ianfm/foc-driver-pcb/README.md

# foc-driver-pcb
BLDC driver aimed at FOC motor control
