ianfm/foc-driver-pcb/drv8323-breakout/drv8323-breakout.kicad_pcb

## KiCad design drv8323-breakout/drv8323-breakout.kicad_pcb (2026-03-18)

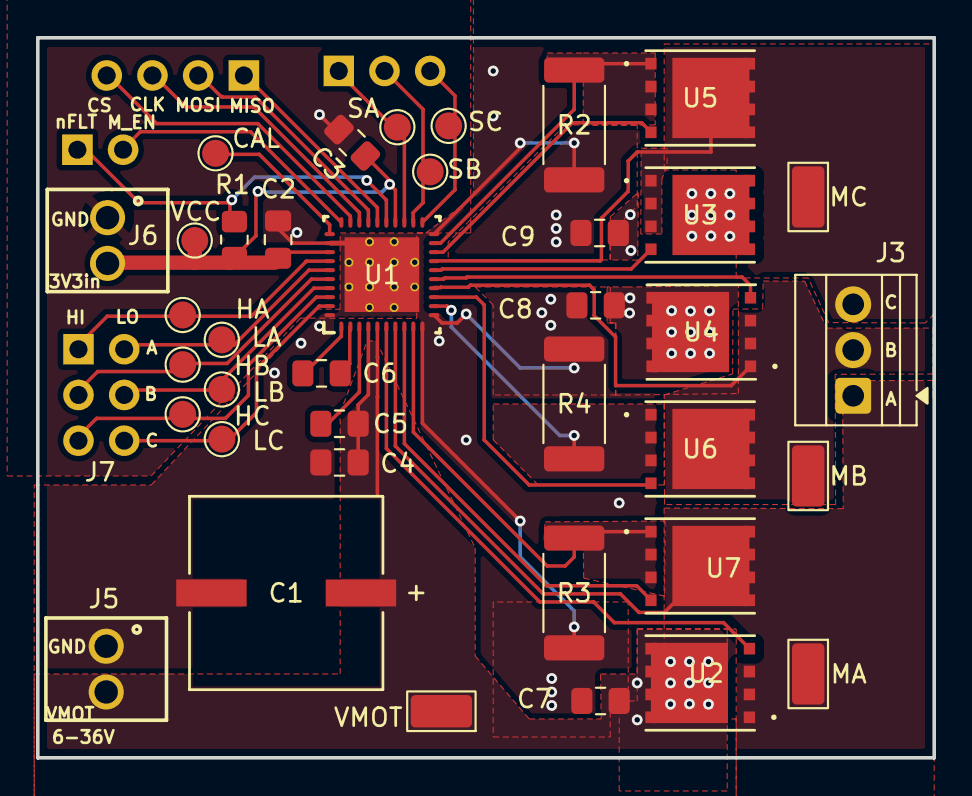
[picture p1: board drv8323-breakout.kicad_pcb from above]

Board: 2 copper layers, 49.8 x 40.0 mm, 43 parts (0 on the bottom side), 35 nets.

Parts:
C1: 47uF; PCAP_10x10-ELECT_NCA
C2, C5: 1 uF; C_0805_2012Metric_Pad1.18x1.45mm_HandSolder
C3, C4: 0.1 uF; C_0805_2012Metric_Pad1.18x1.45mm_HandSolder
C6: 47 nF; C_0805_2012Metric_Pad1.18x1.45mm_HandSolder
C7, C8, C9: C; C_0805_2012Metric_Pad1.18x1.45mm_HandSolder
CAL: TestPoint; TestPoint_Pad_D1.5mm
HA: TestPoint; TestPoint_Pad_D1.5mm
HB: TestPoint; TestPoint_Pad_D1.5mm
HC: TestPoint; TestPoint_Pad_D1.5mm
J1: Conn_01x02_Pin; PinHeader_1x02_P2.54mm_Vertical
J2: Conn_01x04_Pin; PinHeader_1x04_P2.54mm_Vertical
J3: Screw_Terminal_01x03; TerminalBlock_Xinya_XY308-2.54-3P_1x03_P2.54mm_Horizontal
J4: Conn_01x03_Pin; PinHeader_1x03_P2.54mm_Vertical
J5, J6: Screw_Terminal_01x02; ScrewTerminal
J7: Conn_02x03_Odd_Even; PinHeader_2x03_P2.54mm_Vertical
LA: TestPoint; TestPoint_Pad_D1.5mm
LB: TestPoint; TestPoint_Pad_D1.5mm
LC: TestPoint; TestPoint_Pad_D1.5mm
MA: TestPoint; TestPoint_Keystone_5015_Micro_Mini
MB: TestPoint; TestPoint_Keystone_5015_Micro_Mini
MC: TestPoint; TestPoint_Keystone_5015_Micro_Mini
NT2: NetTie_2; NetTie-2_SMD_Pad0.28mm
R1: R_US; R_0805_2012Metric_Pad1.20x1.40mm_HandSolder
R2, R3, R4: CSS2H-2512K-2L00F; R_2512_6332Metric_Pad1.40x3.35mm_HandSolder
SA: TestPoint; TestPoint_Pad_D1.5mm
SB: TestPoint; TestPoint_Pad_D1.5mm
SC: TestPoint; TestPoint_Pad_D1.5mm
U1: DRV8323HRTAR; RTA0040B
U2, U3, U4, U5, U6, U7: CSD18534Q5A; DQJ8
VCC: TestPoint; TestPoint_Pad_D1.5mm
VMOT: TestPoint; TestPoint_Keystone_5015_Micro_Mini

Connections:
/Motor Control/SPA: R3.1, U1.9 (SPA), U7.1 (S), U7.2 (S), U7.3 (S)
/Motor Control/SPB: R4.1, U1.12 (SPB), U6.1 (S), U6.2 (S), U6.3 (S)
/Motor Control/SPC: R2.1, U1.19 (SPC), U5.1 (S), U5.2 (S), U5.3 (S)
AGND: C2.1, C3.1, J6.1, NT2.2, U1.32 (AGND)
CAL: CAL.1, U1.31 (CAL)
MOT_A: J3.1, MA.1, U1.7 (SHA), U2.1 (S), U2.2 (S), U2.3 (S), U7.5 (D), U7.6 (D), U7.7 (D), U7.8 (D), U7.9 (ep)
MOT_B: J3.2, MB.1, U1.14 (SHB), U4.1 (S), U4.2 (S), U4.3 (S), U6.5 (D), U6.6 (D), U6.7 (D), U6.8 (D), U6.9 (ep)
MOT_C: J3.3, MC.1, U1.17 (SHC), U3.1 (S), U3.2 (S), U3.3 (S), U5.5 (D), U5.6 (D), U5.7 (D), U5.8 (D), U5.9 (ep)
MOT_EN: J1.2, U1.30 (ENABLE)
NFLT: J1.1, R1.2, U1.25 (FAULT_N)
unnamed: C6.1, U1.2 (CPH)
unnamed: C6.2, U1.1 (CPL)
unnamed: U1.6 (GHA), U2.4 (G)
unnamed: U1.15 (GHB), U4.4 (G)
unnamed: U1.16 (GHC), U3.4 (G)
unnamed: U1.8 (GLA), U7.4 (G)
unnamed: U1.13 (GLB), U6.4 (G)
unnamed: U1.18 (GLC), U5.4 (G)
unnamed: C5.2, U1.3 (VCP)
PGND: C1.2, C4.2, C7.1, C8.2, C9.2, J5.1, NT2.1, R2.2, R3.2, R4.2, U1.10 (SNA), U1.11 (SNB), U1.20 (SNC), U1.40 (PGND), U1.41 (PAD)
PWM_HA: HA.1, J7.1, U1.34 (INHA)
PWM_HB: HB.1, J7.3, U1.36 (INHB)
PWM_HC: HC.1, J7.5, U1.38 (INHC)
PWM_LA: J7.2, LA.1, U1.35 (INLA)
PWM_LB: J7.4, LB.1, U1.37 (INLB)
PWM_LC: J7.6, LC.1, U1.39 (INLC)
SNSA: J4.1, SA.1, U1.23 (SOA)
SNSB: J4.2, SB.1, U1.22 (SOB)
SNSC: J4.3, SC.1, U1.21 (SOC)
SPI_CLK: J2.3, U1.28 (VDS_SCLK)
SPI_CS: J2.4, U1.29 (GAIN_SCS_N)
SPI_MISO: J2.1, U1.26 (MODE_SDO)
SPI_MOSI: J2.2, U1.27 (IDRIVE_SDI)
VCC: C2.2, C3.2, J6.2, R1.1, U1.24 (VREF), U1.33 (DVDD), VCC.1
V_MOT: C1.1, C4.1, C5.1, C7.2, C8.1, C9.1, J5.2, U1.4 (VM), U1.5 (VDRAIN), U2.5 (D), U2.6 (D), U2.7 (D), U2.8 (D), U2.9 (ep), U3.5 (D), U3.6 (D), U3.7 (D), U3.8 (D), U3.9 (ep), U4.5 (D), U4.6 (D), U4.7 (D), U4.8 (D), U4.9 (ep), VMOT.1
