ianfm/foc-driver-pcb/mosfet-breakout/mosfet-breakout/mosfet-breakout.kicad_pcb

## KiCad design mosfet-breakout/mosfet-breakout/mosfet-breakout.kicad_pcb (2026-03-17)

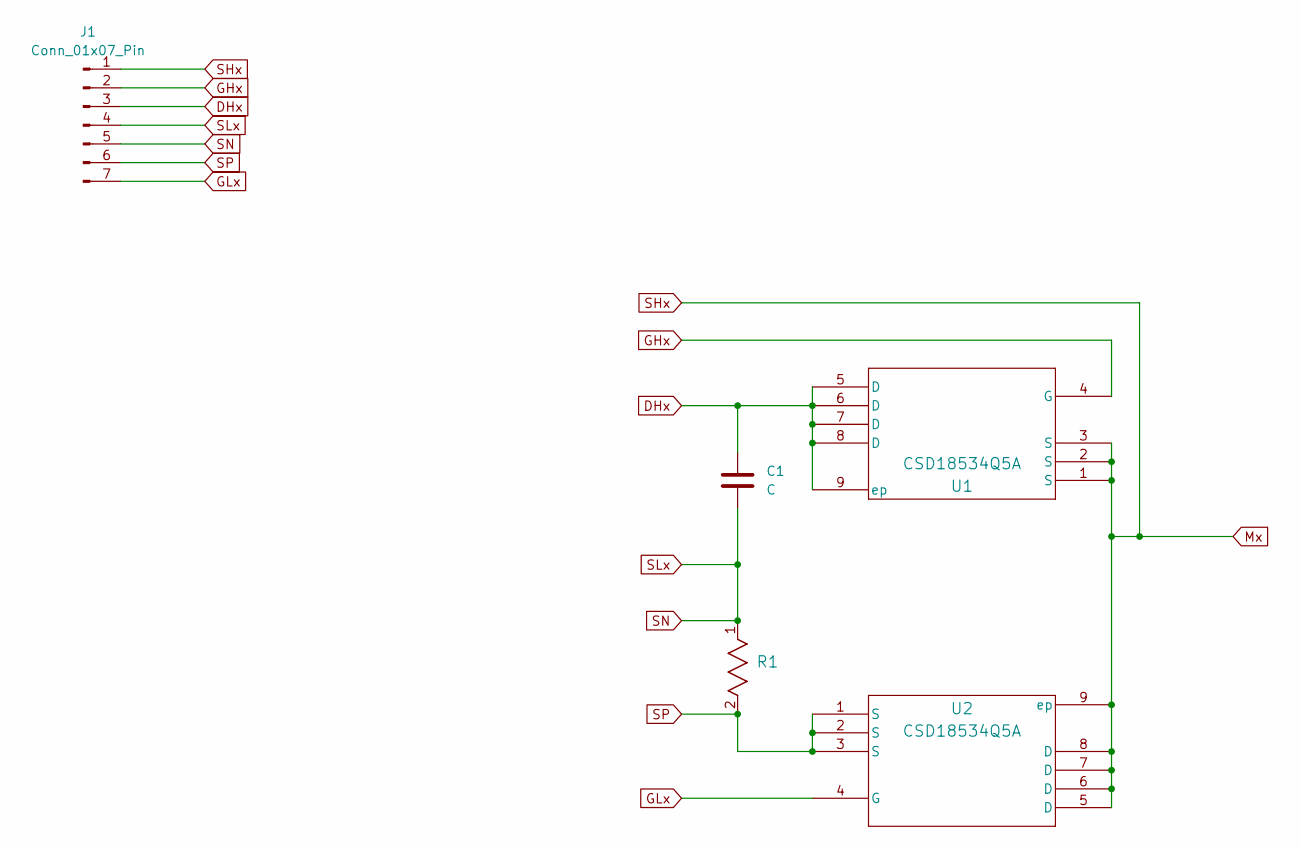
[picture p2: schematic mosfet-breakout.kicad_sch]

Parts:
C1: C; C_0805_2012Metric_Pad1.18x1.45mm_HandSolder
J1: Conn_01x07_Pin; PinHeader_1x07_P2.54mm_Vertical
R1: CSS2H-2512K-2L00F; R_2512_6332Metric_Pad1.40x3.35mm_HandSolder
U1, U2: CSD18534Q5A; DQJ8

Connections:
DHx: C1.1, J1.3, U1.5 (D), U1.6 (D), U1.7 (D), U1.8 (D), U1.9 (ep)
GHx: J1.2, U1.4 (G)
GLx: J1.7, U2.4 (G)
Mx: J1.1, U1.1 (S), U1.2 (S), U1.3 (S), U2.5 (D), U2.6 (D), U2.7 (D), U2.8 (D), U2.9 (ep)
SLx: C1.2, J1.4, J1.5, R1.1
SP: J1.6, R1.2, U2.1 (S), U2.2 (S), U2.3 (S)

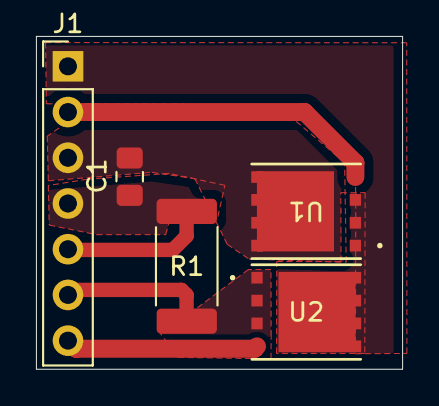
[picture p3: board mosfet-breakout.kicad_pcb from above]

Board: 2 copper layers, 20.3 x 18.5 mm, 5 parts (0 on the bottom side), 6 nets.
