ianfm/foc-driver-pcb/esp32-drv8323-driver/haptic-wheel-pcb.kicad_pcb

## KiCad design esp32-drv8323-driver/haptic-wheel-pcb.kicad_pcb (2026-03-16)

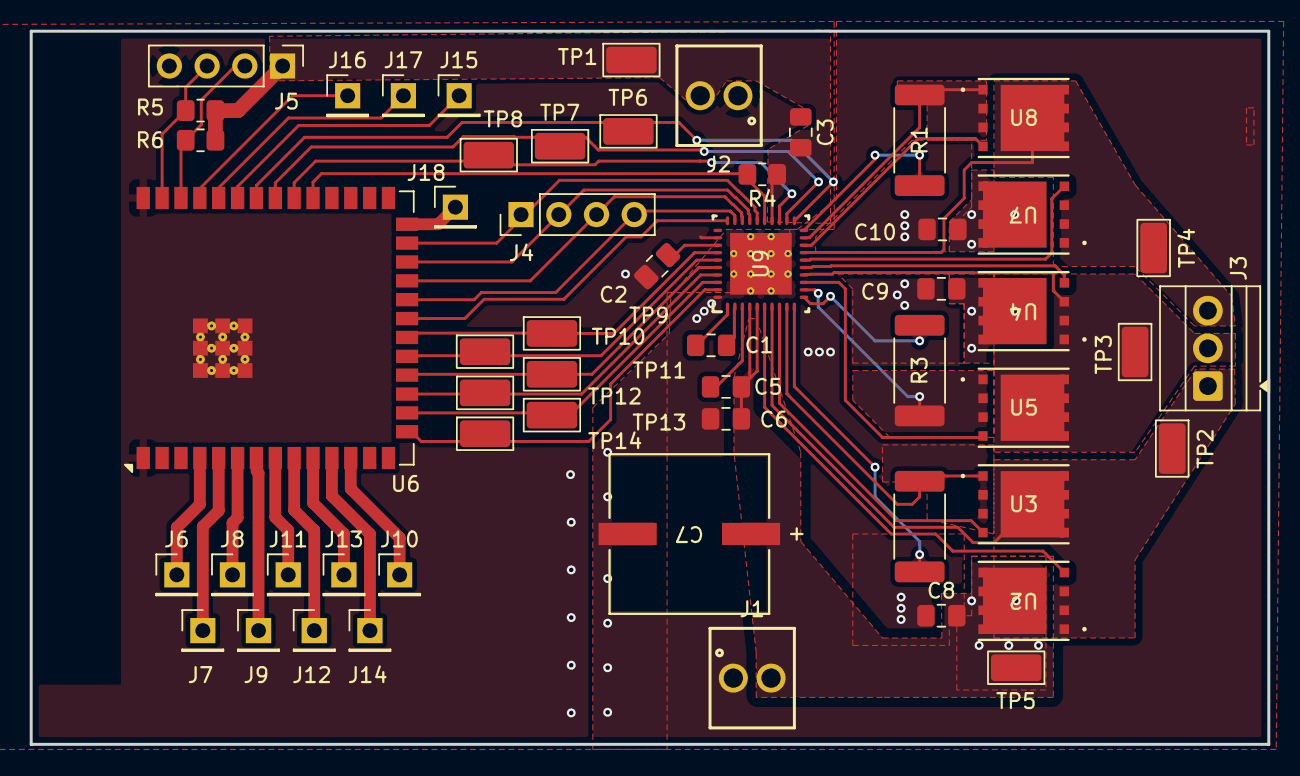
[picture p4: board haptic-wheel-pcb.kicad_pcb from above]

Board: 2 copper layers, 83.3 x 48.0 mm, 55 parts (0 on the bottom side), 53 nets.

Parts:
C1: 47 nF; C_0805_2012Metric_Pad1.18x1.45mm_HandSolder
C2, C5: 1 uF; C_0805_2012Metric_Pad1.18x1.45mm_HandSolder
C3, C6: 0.1 uF; C_0805_2012Metric_Pad1.18x1.45mm_HandSolder
C7: 47uF; PCAP_10x10-ELECT_NCA
C8, C9, C10: C; C_0805_2012Metric_Pad1.18x1.45mm_HandSolder
J1, J2: Screw_Terminal_01x02; ScrewTerminal
J3: Screw_Terminal_01x03; TerminalBlock_Xinya_XY308-2.54-3P_1x03_P2.54mm_Horizontal
J4, J5: Conn_01x04_Pin; PinHeader_1x04_P2.54mm_Vertical
J6, J7, J8, J9, J10, J11, J12, J13, J14, J15, J16, J17, J18: Conn_01x01_Pin; PinHeader_1x01_P2.54mm_Vertical
R1, R2, R3: CSS2H-2512K-2L00F; R_2512_6332Metric_Pad1.40x3.35mm_HandSolder
R4, R5, R6: R_US; R_0805_2012Metric_Pad1.20x1.40mm_HandSolder
TP1, TP2, TP3, TP4, TP5, TP6, TP7, TP8, TP9, TP10, TP11, TP12, TP13, TP14: TestPoint; TestPoint_Keystone_5015_Micro_Mini
U2, U3, U4, U5, U7, U8: CSD18534Q5A; DQJ8
U6: ESP32-S3-WROOM-2
U9: DRV8323HRTAR; RTA0040B

Connections:
/Motor Control/SNA: R2.2, U9.10 (SNA)
/Motor Control/SNB: R3.2, U9.11 (SNB)
/Motor Control/SNC: R1.2, U9.20 (SNC)
/Motor Control/SPA: R2.1, U3.1 (S), U3.2 (S), U3.3 (S), U9.9 (SPA)
/Motor Control/SPB: R3.1, U5.1 (S), U5.2 (S), U5.3 (S), U9.12 (SPB)
/Motor Control/SPC: R1.1, U8.1 (S), U8.2 (S), U8.3 (S), U9.19 (SPC)
AGND: C2.1, C3.1, J2.1, J5.4, U6.1 (GND), U6.40 (GND), U6.41 (GND), U9.32 (AGND)
MOT_A: J3.1, TP2.1, U2.1 (S), U2.2 (S), U2.3 (S), U3.5 (D), U3.6 (D), U3.7 (D), U3.8 (D), U3.9 (ep), U9.7 (SHA)
MOT_B: J3.2, TP3.1, U4.1 (S), U4.2 (S), U4.3 (S), U5.5 (D), U5.6 (D), U5.7 (D), U5.8 (D), U5.9 (ep), U9.14 (SHB)
MOT_C: J3.3, TP4.1, U7.1 (S), U7.2 (S), U7.3 (S), U8.5 (D), U8.6 (D), U8.7 (D), U8.8 (D), U8.9 (ep), U9.17 (SHC)
MOT_EN: U6.21 (IO13), U9.30 (ENABLE)
NFLT: R4.2, U6.31 (IO38), U9.25 (FAULT_N)
unnamed: J6.1, U6.4 (IO4)
unnamed: J7.1, U6.5 (IO5)
unnamed: J8.1, U6.6 (IO6)
unnamed: J9.1, U6.7 (IO7)
unnamed: J10.1, U6.12 (IO8)
unnamed: J11.1, U6.8 (IO15)
unnamed: J12.1, U6.9 (IO16)
unnamed: J13.1, U6.10 (IO17)
unnamed: J14.1, U6.11 (IO18)
unnamed: J15.1, U6.35 (MTMS/IO42)
unnamed: J16.1, U6.37 (TXD0/IO43)
unnamed: J17.1, U6.36 (RXD0/IO44)
unnamed: J18.1, U6.26 (IO45)
unnamed: U2.4 (G), U9.6 (GHA)
unnamed: U3.4 (G), U9.8 (GLA)
unnamed: U4.4 (G), U9.15 (GHB)
unnamed: U5.4 (G), U9.13 (GLB)
unnamed: U7.4 (G), U9.16 (GHC)
unnamed: U8.4 (G), U9.18 (GLC)
unnamed: C1.1, U9.2 (CPH)
unnamed: C1.2, U9.1 (CPL)
unnamed: C2.2, U9.33 (DVDD)
unnamed: C5.2, U9.3 (VCP)
PGND: C6.2, C7.2, C8.1, C9.2, C10.2, J1.1, U9.40 (PGND), U9.41 (PAD)
PWM_HA: TP9.1, U6.20 (IO12), U9.34 (INHA)
PWM_HB: TP11.1, U6.18 (IO10), U9.36 (INHB)
PWM_HC: TP13.1, U6.16 (IO46), U9.38 (INHC)
PWM_LA: TP10.1, U6.19 (IO11), U9.35 (INLA)
PWM_LB: TP12.1, U6.17 (IO9), U9.37 (INLB)
PWM_LC: TP14.1, U6.15 (IO3), U9.39 (INLC)
SCL: J5.2, R6.2, U6.38 (IO2)
SDA: J5.3, R5.2, U6.39 (IO1)
SNSA: TP8.1, U6.32 (MTCK/IO39), U9.23 (SOA)
SNSB: TP7.1, U6.33 (MTDO/IO40), U9.22 (SOB)
SNSC: TP6.1, U6.34 (MTDI/IO41), U9.21 (SOC)
SPI_CLK: J4.3, U6.23 (IO21), U9.28 (VDS_SCLK)
SPI_CS: J4.4, U6.22 (IO14), U9.29 (GAIN_SCS_N)
SPI_MISO: J4.1, U6.25 (IO48), U9.26 (MODE_SDO)
SPI_MOSI: J4.2, U6.24 (IO47), U9.27 (IDRIVE_SDI)
VCC: C3.2, J2.2, J5.1, R4.1, R5.1, R6.1, TP1.1, U9.24 (VREF)
V_MOT: C5.1, C6.1, C7.1, C8.2, C9.1, C10.1, J1.2, TP5.1, U2.5 (D), U2.6 (D), U2.7 (D), U2.8 (D), U2.9 (ep), U4.5 (D), U4.6 (D), U4.7 (D), U4.8 (D), U4.9 (ep), U7.5 (D), U7.6 (D), U7.7 (D), U7.8 (D), U7.9 (ep), U9.4 (VM), U9.5 (VDRAIN)
