ianfm/foc-driver-pcb/(commit log)

2025-12-30 add nascent kicad project to repo
    [MCU.kicad_sch, MotorControl.kicad_sch, Sensors.kicad_sch, haptic-wheel-pcb.kicad_pcb, haptic-wheel-pcb.kicad_sch]
2025-12-30 wire sense resistors
    [MotorControl.kicad_sch]
2026-02-12 routed motor driver fets and shunts
    [DQJ0008A.stp, MCU.kicad_sch, MotorControl.kicad_sch, Sensors.kicad_sch, haptic-wheel-pcb.kicad_pcb, haptic-wheel-pcb.kicad_sch]
2026-02-14 route all 3 fets with shunts in a vertical line
    [MCU.kicad_sch, MotorControl.kicad_sch, haptic-wheel-pcb.kicad_pcb, haptic-wheel-pcb.kicad_sch]
2026-02-18 using vias on SNA/SPA instead of GxA b/c switching speed
    [MCU.kicad_sch, MotorControl.kicad_sch, haptic-wheel-pcb.kicad_pcb]
2026-02-18 full gate reroute with zones and sense lines like the layout guide
    [MotorControl.kicad_sch, haptic-wheel-pcb.kicad_pcb]
2026-02-18 selected mcu pins for sense in, SPI
    [MCU.kicad_sch, MotorControl.kicad_sch, Sensors.kicad_sch, haptic-wheel-pcb.kicad_pcb, haptic-wheel-pcb.kicad_sch]
2026-02-19 big layout - lay pgnd and agnd zones and add SPI header pins
    [MCU.kicad_sch, MotorControl.kicad_sch, haptic-wheel-pcb.kicad_pcb, haptic-wheel-pcb.kicad_sch]
2026-03-17 restore submodule content
    [mosfet-breakout.kicad_pcb, mosfet-breakout.kicad_sch]
2026-03-17 update mosfet symbol ep pin
2026-03-18 re-add drv8323 breakout
    [MCU.kicad_sch, MotorControl.kicad_sch, Sensors.kicad_sch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]
2026-03-18 updated symbols for sanity and PCB for mfg, no DRC errors, only net type ERC errors
    [MotorControl.kicad_sch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]
2026-03-24 v7 submitted to JLC and ordered 03-24-26
    [drv8323-breakout-B_Cu.gbr, drv8323-breakout-B_Mask.gbr, drv8323-breakout-B_Paste.gbr, drv8323-breakout-B_Silkscreen.gbr, drv8323-breakout-Edge_Cuts.gbr, drv8323-breakout-F_Cu.gbr, drv8323-breakout-F_Mask.gbr, drv8323-breakout-F_Paste.gbr]
2026-08-31 feat(firmware): add ESP32-S3 FOC motor driver firmware for DRV8323
    Built, verified, and loaded on Windows 11 (Host: 'Enma') via PlatformIO / ESP-IDF toolchain.
    Target:
    - ESP32-S3-WROOM-1 N16R8 (Xtensa Dual-Core @ 240MHz, 16MB Flash, 8MB Octal PSRAM)
    Build Chain Specification:
    - Operating System: Microsoft Windows 11 (amd64) on host 'Enma'
    - PlatformIO Core: 6.1.19
    - Platform: espressif32 @ 55.3.311 (pioarduino)
    - Framework: framework-espidf @ 3.50505.0 (ESP-IDF v5.5.5)
    - Toolchain: toolchain-xtensa-esp-elf @ 14.2.0+20260121 (GCC 14.2.0)
    - Flasher: tool-esptoolpy @ 5.3.0 (esptool v5.3.0)
    - Build Tools: CMake 4.0.3, Ninja 1.13.1, SCons 4.8.1
    - Python: 3.12.10
    Peripherals & Features:
    - TI DR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
2026-08-31 feat(firmware): add Wi-Fi SoftAP, HTTP REST API, and embedded Web Dashboard
    - Embedded single-page Web UI hosted at http://192.168.4.1 (SoftAP: ESP32-FOC-Driver)
    - Real-time 10Hz telemetry polling (Current, Vq, Limits, Electrical Angle)
    - Interactive sliders for torque voltage, current limit, and emergency trip
    - Hardware protection audit, 0.06V Vds OCP, and UART CLI integration
2026-09-01 feat(web): add DRV8323 Silicon Register Inspector and SPI write endpoints
    - Multi-tab navigation: Control & Telemetry vs DRV8323 Register Inspector
    - Real-time bitfield fault flag breakdown for Registers 0x00 and 0x01
    - Live register controls for OCP, Dead-Time, Gate Slew (IDRIVE), and CSA Gain
    - Added /api/drv_regs and /api/drv_write REST endpoints
2026-09-01 perf(architecture): prioritize real-time FOC loop with zero-overhead on-demand telemetry
    - Telemetry streaming disabled by default (0% CPU/bus overhead)
    - Added 'stream on/off' command to UART CLI
    - Web UI defaults to On-Demand status snapshots with optional 1Hz/5Hz/10Hz stream selector
    - SPI register reads/writes strictly on-demand on user action
    - Core 1 dedicated to 5 kHz FOC control loop; Core 0 handles user services
2026-09-01 fix(httpd): enable LRU socket purging and configure connection resilience
    [main.c]
2026-09-02 build(target): support ESP32-S3-WROOM-2 N32R8 and ensure zero-PSRAM portability
2026-09-02 fix(console): enable native USB Serial/JTAG console and print IP over serial
    [main.c]
2026-09-02 fix(board): set official esp32-s3-devkitc-1-n32r8v board target
2026-09-02 fix(wifi): disable SoftAP completely and enforce pure Station mode
    [main.c]
2026-09-02 fix(boot): eliminate low-side gate shoot-through and enforce idle COAST mode
    [main.c]
2026-09-02 fix(safety): default motor to safe COAST, fix MCPWM compare polarity, decouple encoder task
    [main.c]
2026-09-02 fix(safety): prohibit implicit motor enabling from parameter updates
    [main.c]
2026-09-02 fix(drv): keep DRV8323 completely asleep at boot with zero power until explicit enable
    [main.c]
2026-09-02 feat(foc): add live mechanical angle tracking, encoder standing offset calibration, and hardware sleep fixes
    [main.c]
